rosco-m68k/XoseraBoard/(commit log)

2024-01-04 Initial import
    [Xosera2.kicad_pcb, Xosera2.kicad_sch, Xosera_Bus.kicad_sch, Xosera_FPGA.kicad_sch, Xosera_HDMI.kicad_sch]
2024-02-08 Make a start on placement
    [Xosera2.kicad_pcb, Xosera2.kicad_sch, Xosera_Bus.kicad_sch, Xosera_FPGA.kicad_sch, Xosera_HDMI.kicad_sch]
2024-02-11 Replace all GALs with one 1504
    [Expansion_RAM.kicad_sch, IDE.kicad_sch, Xosera2.kicad_sch, Xosera_Bus.kicad_sch, Xosera_FPGA.kicad_sch, Xosera_HDMI.kicad_sch]
2024-02-11 Fix ERC (mostly) and sort out footprints etc
    [Audio_Filters.kicad_sch, IDE.kicad_sch, Xosera2.kicad_pcb, Xosera2.kicad_sch, Xosera_Bus.kicad_sch, Xosera_FPGA.kicad_sch, Xosera_HDMI.kicad_sch]
2024-02-16 Fix Kicad weirdness
    [Xosera2.kicad_pcb, Xosera_FPGA.kicad_sch]
2024-02-25 Initial layout, delete some useless things
    [Expansion_RAM.kicad_sch, IDE.kicad_sch, UART.kicad_sch, Xosera2.kicad_pcb, Xosera2.kicad_sch, Xosera_Bus.kicad_sch, Xosera_FPGA.kicad_sch]
2024-02-25 Add UART
2024-06-14 Brought-Up XoseRAM Rev. A (#1)
    * Replace Xosera2 with XoseRAM
    * Delete production directory
    * Rename ROSCO_M68K_BUS for clarity
    * Minor tweaks
    * Reorder DV and data pins on FPGA
    * Add a 0.2 mm net tie
    * Wire /DTACK from FPGA to PLD
    * Add Xosera R/W to PLD
    * Make DVI BSEL high for 24-bit mode
    * Final minor tweaks
    * Update dates and license art
    * Update more silkscreen
    * Final tweaks and cleanup
    * First cut new PLD
    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
    [Audio_Filters.kicad_sch, Expansion_RAM.kicad_sch, IDE.kicad_sch, UART.kicad_sch, Xosera2.kicad_pcb, Xosera2.kicad_sch, Xosera_Bus.kicad_sch, Xosera_FPGA.kicad_sch]
2024-11-16 Brought-Up XoseRAM Rev. B (#2)
    * Refresh count not hooked up
    * Init won't fit
    * Hook things up
    * Tidy up state names to reduce clashes
    * Simulation, gtkwave
    * Some fixes, REFRESH_Q latch reset wrong
    * Add 68k address into vectors
    * Fix refresh, not opti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
    [decoder.kicad_sch, filter_calc.ods, level_shifters.kicad_sch, mainboard.kicad_sch, power.kicad_sch, sdram.kicad_sch, xosera.kicad_sch, xosera_audio_filter.kicad_sch]
