rosco-m68k/XoseraBoard/(notices)

Notices in the files:
kicad/xoseram/mainboard.kicad_sch:
Licensed under CERN OHL v.1.2
kicad/xoseram/xoseram.kicad_pcb:
For use with:
Xosera © 2020-2024 Xark and Contributors
PLD Code © 2024 Ross Bamford and Contributors
